badernageral/contadora-sementes-arduino/README.md

# Contadora de sementes com Arduino

Nesse repositório você encontrará um relato da experiência de montagem de uma contadora de sementes com a plataforma Arduino.
