badernageral/contadora-sementes-arduino/suporte_molas.pdf

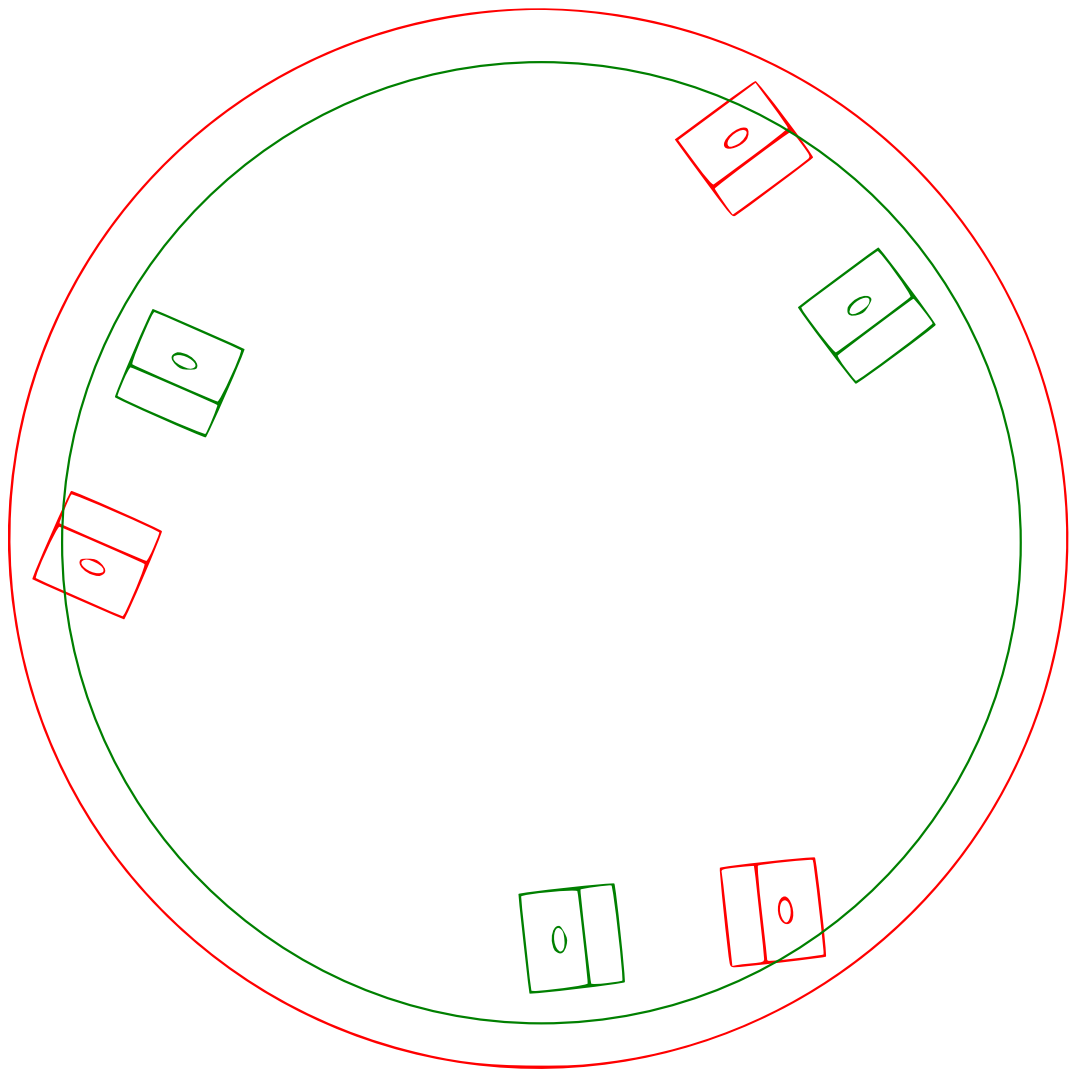
[picture p1: page 1]

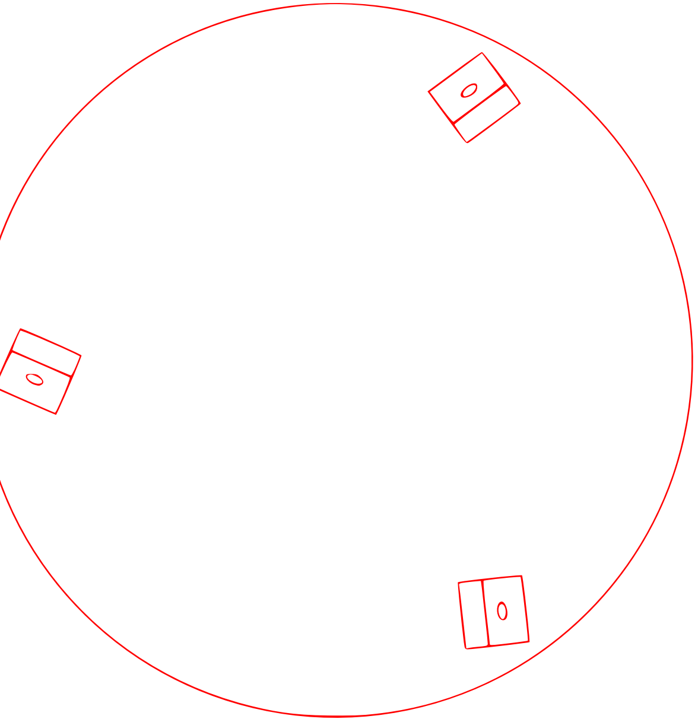
[picture p2: figure]

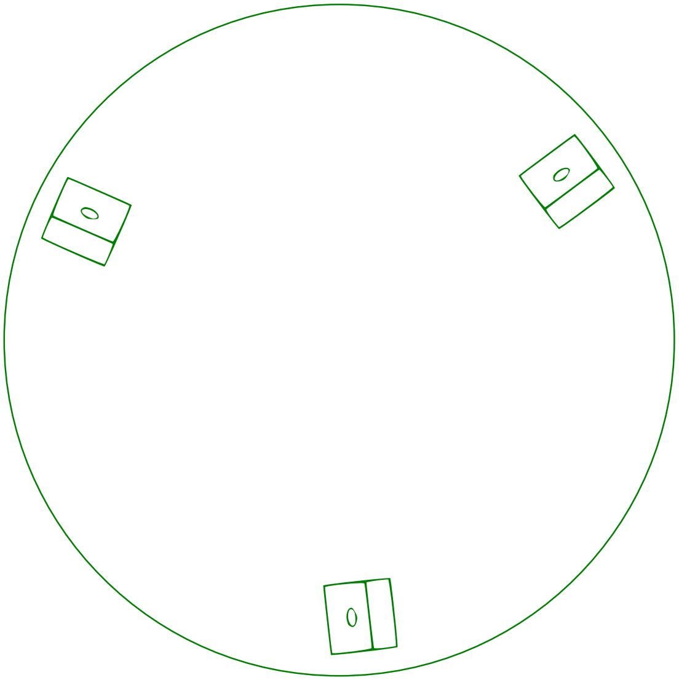
[picture p3: figure]
