badernageral/contadora-sementes-arduino/(list of files, cad)

Other CAD files:
modelo_3d_bandeja.blend
