badernageral/contadora-sementes-arduino/(commit log)

2023-06-26 código arduino
2023-06-26 relatório de construção
2023-06-26 modelo para impressão
2023-06-26 modelo 3D
    [modelo_3d_bandeja.blend]
